surpace0924/InvertedPendulum/Circuit/回路図.png

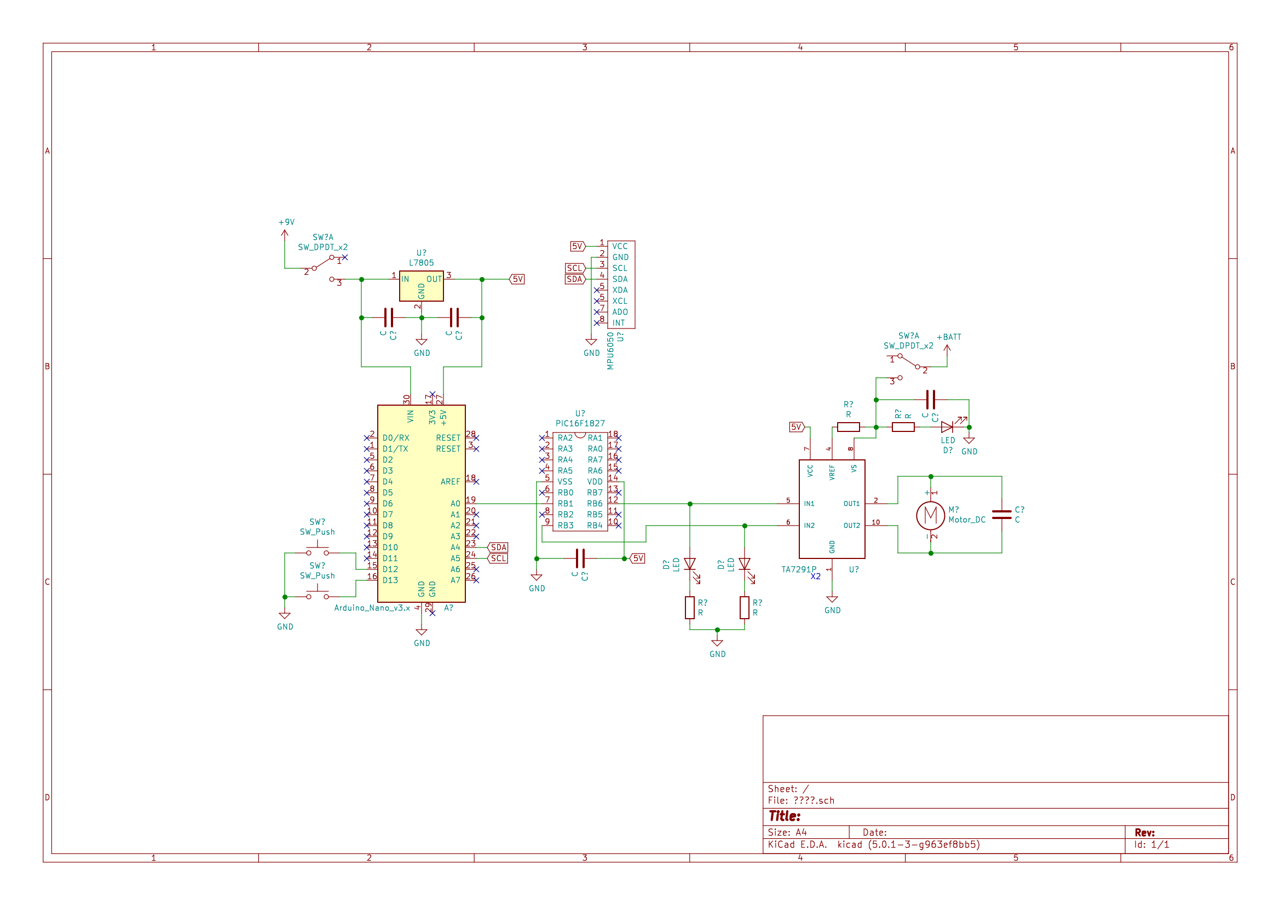
Circuit/回路図.png
