surpace0924/InvertedPendulum/Circuit/結線図.png

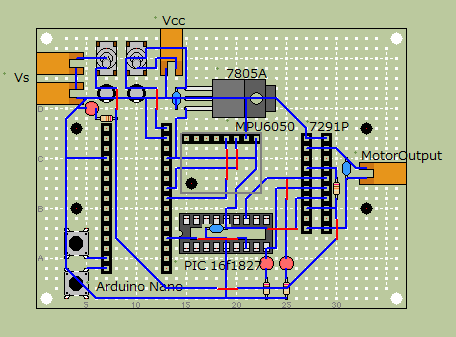
Circuit/結線図.png
