surpace0924/InvertedPendulum/Circuit/回路図データ/倒立振子.kicad_pcb

## KiCad design circuit/bench_psu_0.sch


Parts:
Q1: Q_PNP_Darlington_BCE
Q2, Q3: Q_NPN_BCE
R3: 83.7k
R4: 2k
R_base1: 1k
R_load1: 10
R_shunt1: 0.02
U1, U3: LM358
V1, V2, V3: VSOURCE

Connections:
0: Q2.2 (C), Q3.2 (C), R4.2, R_load1.2, U1.4 (V-), U3.4 (V-), V1.2 (E2), V2.2 (E2), V3.2 (E2)
I_SET: U1.5 (+), V3.1 (E1)
unnamed: Q1.1 (B), R_base1.1
unnamed: Q1.3 (E), R_shunt1.1, U3.3 (+)
unnamed: Q2.1 (B), Q3.1 (B), Q3.3 (E), R3.2, R4.1, U1.1, U1.7
unnamed: Q2.3 (E), R_base1.2
unnamed: R_load1.1, R_shunt1.2, U1.2 (-), U3.2 (-)
unnamed: U1.6 (-), U3.1
VCC: Q1.2 (C), R3.1, U1.8 (V+), U3.8 (V+), V1.1 (E1)
V_SET: U1.3 (+), V2.1 (E1)

Notes on the sheet:
.tran 2n 10u
