surpace0924/InvertedPendulum/(commit log)

2019-01-09 1.0 現状
2019-01-09 1.0b サブモジュールの削除
2019-01-09 1.0c Arduinoのコードの追加
2019-01-10 1.0d 報告書の追加
2019-01-13 配線図の追加
2019-01-15 1.1 refactor: リファクタリング（動作確認済み）
2019-01-16 回路図データの追加
    [倒立振子.kicad_pcb, 倒立振子.sch]
2019-01-16 回路図の画像を追加
    [倒立振子.kicad_pcb, 倒立振子.sch]
2019-01-21 印刷用のパワポを終わらせた
2019-01-29 提出用の報告書を書いた
2019-02-22 発表資料に画像と動画を追加
2019-02-22 発表資料にPIDの説明を追加
